ccrome/temperature_scanner/3d-files/clip-piece.stp

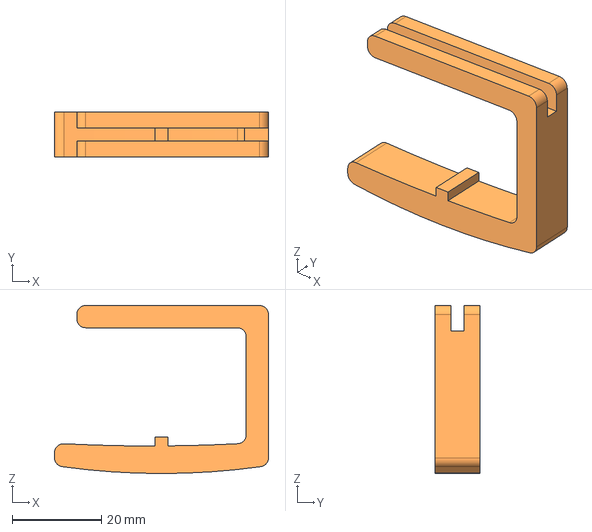
[picture p11: CAD file, 2021-09-26]
3d-files/clip-piece.stp
48.0 x 10.0 x 37.7 mm
