ccrome/temperature_scanner/3d-files/pogo-piece.stp

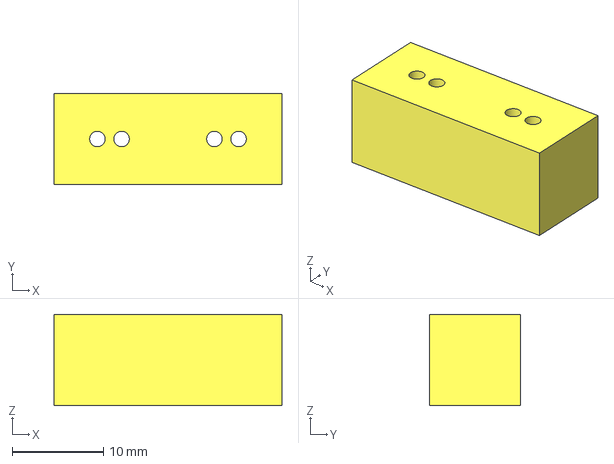
[picture p12: CAD file, 2021-09-26]
3d-files/pogo-piece.stp
25.0 x 10.0 x 10.0 mm
