ccrome/temperature_scanner/(list of files, cad)

Other CAD files:
3d-files/OldVersions/pogo-holder-base.0001.ipt
3d-files/clip-piece.ipt
3d-files/clip-piece.stl
3d-files/pogo-holder-base.iam
3d-files/pogo-holder-base.ipt
3d-files/pogo-piece.ipt
3d-files/pogo-piece.stl
