ccrome/temperature_scanner/(commit log)

2021-09-26 initial revision
    [clip-piece.ipt, clip-piece.stl, clip-piece.stp, pogo-holder-base.0001.ipt, pogo-holder-base.iam, pogo-holder-base.ipt, pogo-piece.ipt, pogo-piece.stl]
2021-10-01 Added temperature sensor
2021-10-01 finer resolution heatmap image
